Bytewerk/QuadCAN-FD/schematics.pdf

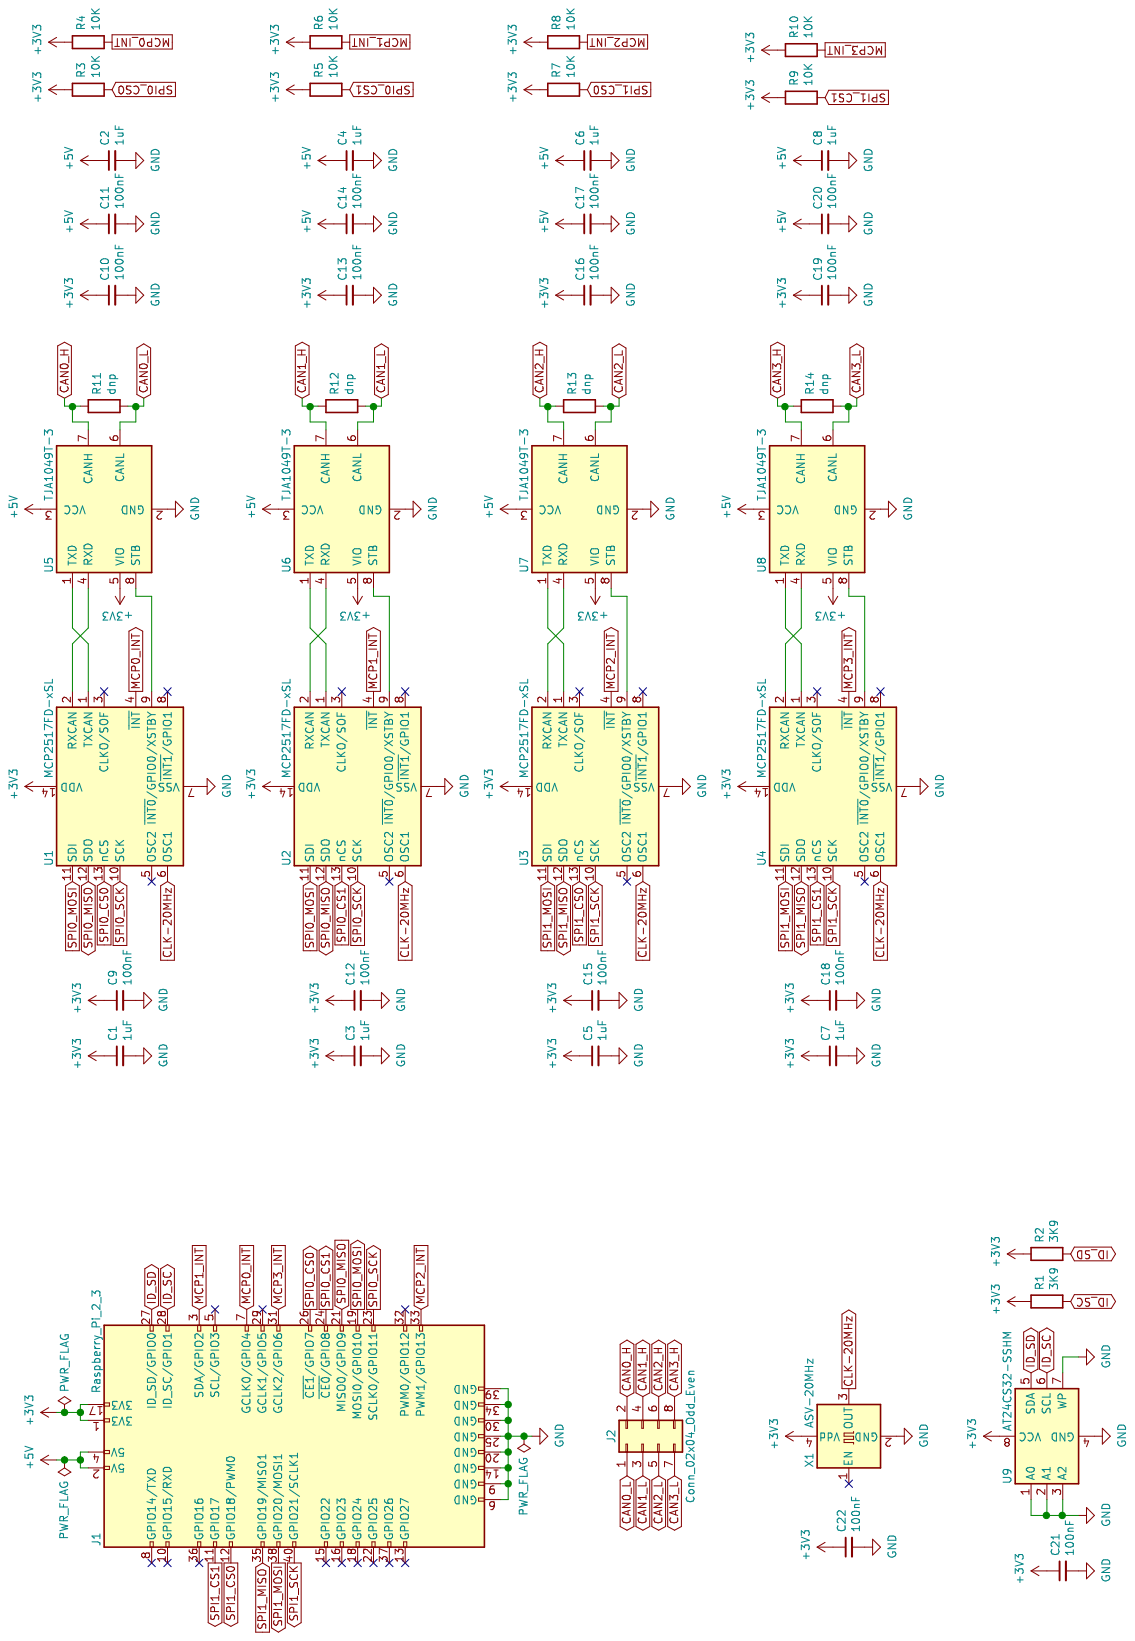
[picture p1: page 1]
