Bytewerk/QuadCAN-FD/QuadCAN-FD.kicad_pcb

## KiCad design QuadCAN-FD.kicad_pcb (2018-09-10)

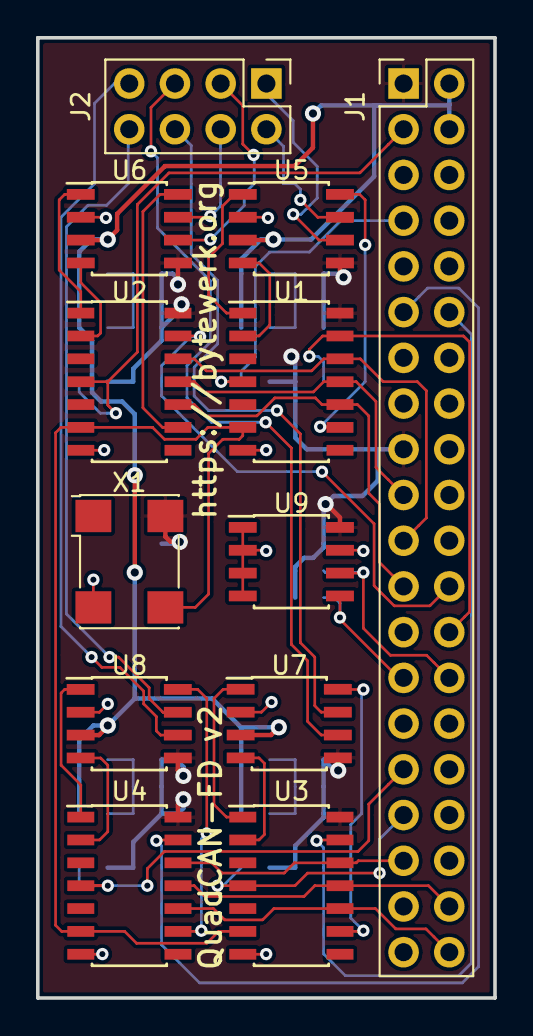
[picture p2: board QuadCAN-FD.kicad_pcb from above]

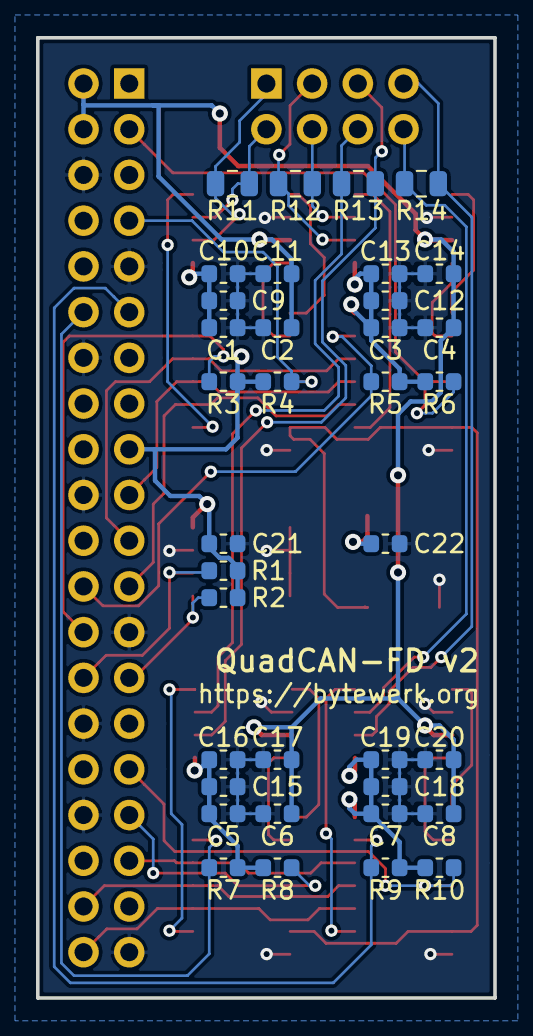
[picture p3: board QuadCAN-FD.kicad_pcb from below]

Board: 2 copper layers, 25.4 x 53.3 mm, 48 parts (36 on the bottom side), 40 nets.

Parts:
C1, C2, C3, C4, C5, C6, C7, C8: 1uF; C_0603_1608Metric
C9, C10, C11, C12, C13, C14, C15, C16, C17, C18, C19, C20, C21, C22: 100nF; C_0603_1608Metric
J1: Raspberry_Pi_2_3; PinHeader_2x20_P2.54mm_Vertical
J2: Conn_02x04_Odd_Even; PinHeader_2x04_P2.54mm_Vertical
R1, R2: 3K9; R_0603_1608Metric
R3, R4, R5, R6, R7, R8, R9, R10: 10K; R_0603_1608Metric
R11, R12, R13, R14: dnp; C_0805_2012Metric
U1, U2, U3, U4: MCP2517FD-xSL; SOIC-14_3.9x8.7mm_P1.27mm
U5, U6, U7, U8: TJA1049T-3; SOIC-8_3.9x4.9mm_P1.27mm
U9: AT24CS32-SSHM; SOIC-8_3.9x4.9mm_P1.27mm
X1: ASV-20MHz; Oscillator_SMD_Abracon_ASV-4Pin_7.0x5.1mm

Connections:
+3V3: C1.1, C3.1, C5.1, C7.1, C9.1, C10.1, C12.1, C13.1, C15.1, C16.1, C18.1, C19.1, C21.1, C22.1, J1.1, J1.17, R1.1, R2.1, R3.1, R4.1, R5.1, R6.1, R7.1, R8.1, R9.1, R10.1, U1.14, U2.14, U3.14, U4.14, U5.5, U6.5, U7.5, U8.5, U9.8, X1.4
+5V: C2.1, C4.1, C6.1, C8.1, C11.1, C14.1, C17.1, C20.1, J1.2, J1.4, U5.3, U6.3, U7.3, U8.3
CAN0_H: J2.2, R11.1, U5.7
CAN0_L: J2.1, R11.2, U5.6
CAN1_H: J2.4, R12.1, U6.7
CAN1_L: J2.3, R12.2, U6.6
CAN2_H: J2.6, R13.1, U7.7
CAN2_L: J2.5, R13.2, U7.6
CAN3_H: J2.8, R14.1, U8.7
CAN3_L: J2.7, R14.2, U8.6
CLK-20MHz: U1.6, U2.6, U3.6, U4.6, X1.3
GND: C1.2, C2.2, C3.2, C4.2, C5.2, C6.2, C7.2, C8.2, C9.2, C10.2, C11.2, C12.2, C13.2, C14.2, C15.2, C16.2, C17.2, C18.2, C19.2, C20.2, C21.2, C22.2, J1.6, J1.9, J1.14, J1.20, J1.25, J1.30, J1.34, J1.39, U1.7, U2.7, U3.7, U4.7, U5.2, U6.2, U7.2, U8.2, U9.1, U9.2, U9.3, U9.4, U9.7, X1.2
ID_SC: J1.28, R1.2, U9.6
ID_SD: J1.27, R2.2, U9.5
MCP0_INT: J1.7, R4.2, U1.4
MCP1_INT: J1.3, R6.2, U2.4
MCP2_INT: J1.33, R8.2, U3.4
MCP3_INT: J1.31, R10.2, U4.4
unnamed: U1.1, U5.1
unnamed: U1.2, U5.4
unnamed: U1.9, U5.8
unnamed: U2.1, U6.1
unnamed: U2.2, U6.4
unnamed: U2.9, U6.8
unnamed: U3.1, U7.1
unnamed: U3.2, U7.4
unnamed: U3.9, U7.8
unnamed: U4.1, U8.1
unnamed: U4.2, U8.4
unnamed: U4.9, U8.8
SPI0_CS0: J1.26, R3.2, U1.13
SPI0_CS1: J1.24, R5.2, U2.13
SPI0_MISO: J1.21, U1.12, U2.12
SPI0_MOSI: J1.19, U1.11, U2.11
SPI0_SCK: J1.23, U1.10, U2.10
SPI1_CS0: J1.12, R7.2, U3.13
SPI1_CS1: J1.11, R9.2, U4.13
SPI1_MISO: J1.35, U3.12, U4.12
SPI1_MOSI: J1.38, U3.11, U4.11
SPI1_SCK: J1.40, U3.10, U4.10
