Bytewerk/QuadCAN-FD/(commit log)

2018-06-29 initial checkin
    [raspi3-4xMCP2517FD-B.Cu.gbl, raspi3-4xMCP2517FD-B.Mask.gbs, raspi3-4xMCP2517FD-B.Paste.gbp, raspi3-4xMCP2517FD-B.SilkS.gbo, raspi3-4xMCP2517FD-Edge.Cuts.gm1, raspi3-4xMCP2517FD-F.Cu.gtl, raspi3-4xMCP2517FD-F.Mask.gts, raspi3-4xMCP2517FD-F.Paste.gtp]
2018-08-31 add bom csv
    [BOM.csv]
2018-09-09 3 devices working!
2018-09-10 make v2
    [BOM.csv, raspi3-4xMCP2517FD.kicad_pcb, raspi3-4xMCP2517FD.sch]
2018-09-10 rename project
    [QuadCAN-FD-B.Cu.gbl, QuadCAN-FD-B.Mask.gbs, QuadCAN-FD-B.Paste.gbp, QuadCAN-FD-B.SilkS.gbo, QuadCAN-FD-Edge.Cuts.gm1, QuadCAN-FD-F.Cu.gtl, QuadCAN-FD-F.Mask.gts, QuadCAN-FD-F.Paste.gtp]
2018-09-11 use latest driver
2018-09-12 add udev rules file for consistant device names
